Andryushik/blinds_homekit_esp32/(commit log)

2025-12-07 Implement Matter integration for shades control, add LED handling, and update README
2025-12-08 Refactor for Matter integration: update Wi-Fi handling with WiFiManager, enhance LED control, and improve README documentation.
2025-12-09 Enhance LED control during Wi-Fi connection: reset LED state on mode entry, adjust brightness for calibration and connection states, and improve toggle functionality.
    [shades_homekit_esp32.ino]
2025-12-10 Refactor shade control logic: replace global targetPercent with state.targetPercent, remove unused Wi-Fi handling, and update README for HomeSpan integration.
    [shades_homekit_esp32.ino, web.cpp]
2025-12-11 Refactor logging and improve initialization: replace Serial prints with DPRINTF for consistency, enhance setup feedback, and adjust HomeKit display logic based on pairing status.
    [HomeKitShade.h, HomeSpanConfig.cpp, shades_homekit_esp32.ino, web.cpp]
2025-12-12 Update README for clarity: enhance feature descriptions, improve formatting, and correct LED status information.
2025-12-12 Refactor pin assignments documentation: remove outdated comments and clarify LED and button usage.
2026-03-02 Update README with new 3D printed parts link and add web UI screenshot
2026-04-04 Refactor file system usage from SPIFFS to LittleFS, add device identity generation, and enhance web UI with new HTML/CSS structure
2026-05-24 Add remote telnet debug console and motor-stall diagnostics
    - New RemoteLog (port 23, debug builds only) streams all DPRINT
    output to Serial AND a connected telnet client; bundled
    log-blinds.sh provides timestamped capture with auto-reconnect.
    - Motor loop refactored: motorTick() extracted and called four
    times per loop iteration so HomeSpan/web blocking can't starve
    stepper.run() on the single-core ESP32-C6.
    - HomeKit position updates throttled to 500 ms during motion to
    reduce TLS notification overhead.
    - Diagnostics surfaced via telnet:
    * 5 s heartbeat with uptime / heap / RSSI / mode / pos / target / dist
    * SLOW LOOP warning when an iteration exceeds 50 ms
    * Rese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
    [HomeKitShade.h, blinds_homekit_esp32.ino]
2026-05-24 Add flash-debug.sh / flash-release.sh
    One-shot compile + OTA scripts for the two-device setup. Accept
    left / right / both / <host>; default is left (192.168.2.220).
    Compile once, upload to each target sequentially.
2026-05-24 log-blinds.sh: accept left/right alias and tag each line
    So both devices can write to the same blinds.log in parallel — each
    line now carries [HH:MM:SS][left|right] making the source obvious.
    Append-writes of short lines are atomic on POSIX, so the file stays
    intact under two concurrent writers.
2026-05-24 Extract diagnostic helpers into Diagnostics.{h,cpp}
    Moves resetReasonStr / gResetReason / WiFi event handler / brownout
    disable out of the main .ino, where they were noise. Main file now
    calls diag_disableBrownout / diag_init / diag_installWiFiEventLogger
    and stays focused on motor/HomeKit logic.
    Also: WiFi.setSleep(false) restored, esp_brownout_disable() called as
    a temporary workaround for motor-pulse VCC dips on the 5V rail. Both
    are marked for removal once a bulk capacitor is in place.
    [blinds_homekit_esp32.ino]
2026-05-24 flash-*.sh: add --protocol network for OTA uploads
    Without an explicit --protocol, recent arduino-cli/esptool treats the
    IP-as-port as a serial device and fails with "port is busy or doesn't
    exist". Force network protocol so OTA works reliably.
2026-05-30 Remove brownout-disable workaround (bulk cap installed on both blinds)
    A 6.3V 3300µF 10x20 low-impedance electrolytic was soldered to the 5V
    input of each XIAO. Verified on 220 (the farther/more flaky unit) with
    five close/open/preset cycles: no BROWNOUT resets, uptime monotonic
    through all motor activity. The BOD is back to its default enabled
    state — if a real supply problem returns, the chip will reset cleanly
    and the reason will surface in the telnet banner.
    [blinds_homekit_esp32.ino]
